YunRah2103/Remotion-gpt-chat/docs/modelling-kit/RECOVERY-2026-10-21.md

# Frozen-session recovery and visual audit

Recovered `30c1e799a62d43b73191cda30ba57cf82ebdecee` without replacing the branch or PR 233.
Implementation revision: `cf876818b2cf08c7ddab2bc3cc90a7d7310904a3`.

## Recovered media

Downloaded aggregate artifact **12380431702**, run **39669223178**.
ZIP SHA256: `207369eb3f63820cdb3c8d020929798d0ff10ee33dd51af45197af62c43ca4a2`.
All eleven MP4s passed the existing local verifier: native 1920x1080 or
1080x1920, H.264/yuv420p, 30fps, full decode and motion checks.
2,040 decoded frames were unique. Sequential 0.5-second samples from every
MP4 were visually inspected, including both driver/cabin and internal-system views.

The recovered dummy demonstrates seated grip, braking/impact posing and return
with visible seat/restraint hardware. Mechanical previews demonstrate the front
and rear layouts. This audit does not establish catalogue-wide collision clearance.
The body models remain stylised. Mechanical overview parts are small at portrait
scale; production agents should select dedicated close-ups when teaching a part.

## Corrections

- Portrait exterior overviews previously zoomed into crops late in each segment.
  They now retain the complete padded vehicle bounds throughout the orbit.
  Landscape detail shots and purposeful failed-wheel close-ups are retained.
- Camera-side lamps and rails crossed the Formula inspection view. Preview
  dressing now uses the far side of the road. The default scenery factory keeps
  both sides for other consumers and still uses six instanced draw groups.
- Collision/rewind reversed distance and damage but advanced the engine/particle
  clock. It now returns the reversed absolute frame, with paired 24/30/60fps tests.
  Negative seeks return the initial nonnegative animation state.

Four added regressions cover camera bounds, clear camera-side dressing,
rewind timing and negative seeks. Floating-point time comparisons use 1e-10
absolute tolerance to accommodate equivalent fractional timestamps.

## Automated verification

GitHub validation job **119483102384** passed TypeScript, **105 tests / zero
failures**, performance measurements and all eleven GLB export/roundtrip checks.
Composition review **39675194314** passed. The local complete suite also
finished with **105 passed / zero failures**.

## Native verification

New native workflow: https://github.com/YunRah2103/Remotion-gpt-chat/actions/runs/39675194371

Composition review: https://github.com/YunRah2103/Remotion-gpt-chat/actions/runs/39675194314

Both workflows passed at the implementation revision above. All eleven native
30fps video jobs and aggregate colour/decode/motion checks passed. Final aggregate
artifact: **12381493187** (all eleven MP4s, stills and verification reports).
ZIP SHA256: `5c06705c0c84eeab2e68c3a2a212e2e457f7034fe6a1933044ef068470d396d2`.

Downloaded the final pack and visually inspected sequential frames from every
updated MP4. Portrait A retains all three complete cars across each segment;
Formula C no longer has camera-side poles occluding the cutaway. Driver and
mechanical previews retain the recovered models and motions. Deliberate tyre
and Formula detail shots can still crop vehicle extremities. Some far-side lamp
heads pass behind the header; the kit demos are inspection footage, not final
captioned episode masters.

Local native rendering was attempted but Chromium download failed at the
network proxy; no render checks were bypassed. Native rendering/verification
instead completed through the established GitHub workflow.

| Preview | Landscape artifact | Portrait artifact |
| --- | --- | --- |
| A: exterior heroes | 12382578106 | 12381877122 |
| B: failed tyre | 12381907781 | 12382077676 |
| C: Formula floor | 12382621764 | 12382501728 |
| D: driver/cabin | 12383065841 | 12382187481 |
| E: shared internals | 12382437074 | 12382191356 |

Baseline artifact: 12381842418. All artifact IDs belong to native run 39675194371.
Download: https://github.com/YunRah2103/Remotion-gpt-chat/actions/runs/39675194371/artifacts/12381493187

This completes the recovery and targeted correction pass, not a premium
catalogue overhaul. Vehicle-specific powertrain plumbing, motorcycle riders,
full passenger rigs and individual model/collision approval across all variants
remain future work. Reuse the existing quick-start API and preserved models.

Vehicle, driver, restraint and mechanical geometry is unchanged in this pass.
EP003/EP004 sources are unchanged. No merge is authorized.
