YunRah2103/Remotion-gpt-chat/production/midnight_emerald/BOULEVARD_DB12_4K_EDITOR_HANDOFF_20261014.md

# YUNEX Midnight Emerald — Boulevard DB12 4K Supplement (14 October 2026)

**Verified native 4K MOVING FOOTAGE acquired.** Not the pre-existing South-of-France aerial material. This source was retrieved from the Boulevard editorial Vimeo embed.

- Publisher source: https://boulevard.co/post/videos/aston-martin-db12-video/
- Native Vimeo embed: https://player.vimeo.com/video/1006099458?h=efc07e05d4
- Authenticated GitHub original asset: https://github.com/YunRah2103/Remotion-gpt-chat/actions/runs/38601150775/artifacts/11913284188
- GitHub Actions conclusion: PASS; original MP4 + original 15-frame contact sheet + JSON probe manifest in artifact.
- **Native file:** `boulevard-db12-editorial.mp4`; 3840×2160 25fps H264; 63.680 sec; 166,267,232 bytes; SHA256 `1d4c8e1e93582cddf85012ab4ab8e524ebbe268225f58b0383ce40dc37421ccf`; full decode PASS.
- **Crucial appearance note:** actual DB12 is very dark *navy/blue-black*, NOT Iridescent Emerald. Some frames have a small BOULEVARD upper-right watermark. Copyright/publication rights are **NOT VERIFIED**. Treat as PRIVATE EDITORIAL REVIEW only until Boulevard and relevant music rights are cleared.
- User's existing original official green 1080p source was NOT re-downloaded and has not been changed.
- The user's Godfather song was not present in this footage specialist session; musical recommendations are phrase-relative (not actual beat timestamps).

## Verified editorial selections (original 4K source IN–OUT)

| Source IN–OUT | Visual | Music-relative suggested usage |
|---|---|---|
| 13.10–14.75 | elegant full side profile by woodland road | sculptural setup |
| 15.10–17.62 | rear-three-quarter beside scenic twisty road | road phrase continuation |
| 18.05–20.52 | very sunlit rear corner, reflection glint | lyrical lift |
| 20.94–22.86 | elevated moving rear-follow down winding road | landscape breathing moment |
| 41.78–43.46 | tight rear lamp and metallic panel reflections | refined detail punctuation |
| 43.55–45.38 | full front-three-quarter hero in architecture | orchestral entrance |
| 45.62–47.48 | moving fender vent, wheel and sculpted panel | musical flourish |
| 47.68–49.38 | driver cockpit, steering and cabin | intimate piano/strings |
| 49.56–51.40 | Bowers & Wilkins door speaker / quilted leather | romantic detail |
| 51.85–54.70 | premium frontal DB12 wide/near hero | melody climax |

**Preview media:** 10 independent 1920×1080 H.264 25fps muted MP4 excerpts prepared in specialist session; all individual FFprobe and full FFmpeg decode PASS; each SHA256 and exact timecode in companion `MANIFEST.json`. The original remains 4K for Master Editor to relink.

**Editorial recommendation:** Source is technically high grade with valuable *new* non-aerial shot categories (front, side, paint, wheel, luxurious interior), but NOT a drop-in emerald-colour match. The Master Editor must decide whether to incorporate blue/black detail shots, obtain licenced emerald footage, or make an intentional colour/story shift. Do not make false claims about same paint. Avoid title-heavy opening 0–12s and the repeated estate/drone 24–40s. Avoid assuming every shot is car driving: several are stationary subject/camera motion.

**Source rights:** Download does not itself grant publication licence. Contact publisher or filmmaker before posting. This is NOT an approved public distribution package.
