YunRah2103/Remotion-gpt-chat/production/mclaren_p1/episode003/V3_REMNANT_EDITOR_HANDOFF_20261016.md

# YUNEX EP003 — Remnant Media McLaren P1 V3 private cinematic footage selects

**Source-verified technical footage acquisition COMPLETE.** **Premium 4–7 fully approved footage rescue goal NOT completely achieved**: visually strong footage was acquired, but breathtaking unclipped 9:16 closer and genuine P1 on-track airbrake motion during braking remain unverified. No editor film has been edited.

## New source and asset proof

- Original filmmaker: **Remnant Media**; `https://www.youtube.com/watch?v=z_U29fm1nkk`. Source footage portrays one vivid **orange** road-going McLaren P1 in night garage and moving street shots; Sony FX3/MOVMAX as credited by filmmaker's source description. Does not match older **silver** car daylight footage.
- Authenticated S25 V4 source [issue #124](https://github.com/YunRah2103/Remotion-gpt-chat/issues/124) **PASS**. Owner-only **draft GitHub Release asset 647820346**, full original 0–120s, **1920×1080 H.264**, original SHA256 `a6e41655b28bdede9f778787286e8e851c33563a6f979355ac9cfdb395fc87eb`, full decode verified.
- Original still frame and center-crop QA [run 38927813240](https://github.com/YunRah2103/Remotion-gpt-chat/actions/runs/38927813240), 4fps timeline QA [run 38928304233](https://github.com/YunRah2103/Remotion-gpt-chat/actions/runs/38928304233).
- Seven-candidate verified private MP4 select builder [run 38937212932](https://github.com/YunRah2103/Remotion-gpt-chat/actions/runs/38937212932), output [artifact ID 12061712129](https://github.com/YunRah2103/Remotion-gpt-chat/actions/runs/38937212932/artifacts/12061712129). Contains **7 independent muted 1080p MP4s, 7 moving 9:16 cropped previews, 7 FFprobe records, wide and vertical 6fps contact sheets, correct SHA256 manifest**. Tool generated archive strips root `v2/`, so local handoff normalized verification paths before distribution.
- Curated final 5-shot owner-only ChatGPT package **`YUNEX_EP003_REMNANT124_V3_CURATED_5_PRIVATE.zip`**, 5,837,567 bytes, 28 entries including 10 actual MP4s. **Every one of 10 MP4s independently full-decoded PASS, SHA256 checked PASS, ZIP CRC PASS.** Detailed JSON and probes packaged; direct download link is available in the owner's ChatGPT conversation (it is not a public GitHub asset).

## Exact ORIGINAL video timecodes (0-based YouTube time)

| Curated MP4 basename | Source seconds | Editorial verdict | 1080p MP4 SHA256 |
|---|---:|---|---|
| `P1_OPEN_NIGHT_LOW_FRONT` | **61.73–63.60** | **GO** for fast-moving low frontal opening; trim before crop loses nose | `20623a48565687ecbd69ee011d066b0ba19da46851965acd8c0fad0d4afadc00` |
| `P1_MID_NIGHT_SIDE_RIG` | **58.75–60.95** | **GO** for same-car moving orange night side tracking | `a5658a1f1c8bdb992d9c7ee5a71090bfe8703243bc946a91ce9d46863b4af0d5` |
| `P1_MID_NIGHT_REAR_TRACK` | **55.30–57.15** | **CONDITIONAL** for blue-lit rear rolling, avoid left-edge crop | `0ca82fc004de4caefa1a17f168e60d4f8eb07366c46390f2a5da9c42d3b3b259` |
| `P1_END_NIGHT_REAR_ESCAPE` | **88.05–90.05** | **CONDITIONAL**, actual orange P1 rolling rear three-quarter with red-blue reflection; not an extraordinary guaranteed final shot | `33319e4c320b1052c798afe2119266b7df0d12aca64b624d4c57c569a47c50a2` |
| `P1_AERO_STATIONARY_WING_DETAIL` | **33.01–33.72** | **GO FOR STATIC MECHANICAL CONTEXT ONLY**: real raised rear wing on parked P1, camera physically moves, wing does NOT actuate | `0a4ebad801ae2cd819f5a941b6246b465e44591cfa52e88b445621714bee7a5b` |

**Private packet directory**: `ORIGINAL_1080P_SELECTS/` full landscape H.264, `VERTICAL_PREVIEWS_540x960/` real 9:16 center crops and `CONTACT_SHEETS/` images, `PRIVATE_EDITOR_MANIFEST.json`, `PROBES/`, `SHA256SUMS.txt`, `EDITOR_START_HERE.md`.

## Director execution notes

1. DO NOT randomly mix silver daytime P1 with orange neon/night P1; if using new pack, establish a visually intentional night chapter with cohesive car and grade.
2. Put `P1_OPEN_NIGHT_LOW_FRONT` as a possible first-frame hook. Real moving footage, P1 close and recognisable.
3. Cut `P1_MID_NIGHT_SIDE_RIG`, `P1_MID_NIGHT_REAR_TRACK` into a short coherent real-motion passage. Only use real duration; do not repeat, reverse or artificially duplicate to pad.
4. `P1_END_NIGHT_REAR_ESCAPE` is not an unconditional jaw-dropping end; review on device before approval, possibly keep previous edit ending if better.
5. `P1_AERO_STATIONARY_WING_DETAIL` can be paired with separate accurate animated engineering demonstration but **MUST NOT be captioned as wing deploying under braking**. No obtained film actually proved moving wing pitch on track.
6. **No source audio replacement**; preserve any user-approved soundtrack and previous documentary master. This job delivered footage only, not the edited documentary or video MP4.

## Honest output and rights limitations

- No native `1080x1920` output from source: vertical motion previews are 540×960 **UPSCALES** of a 608×1080 center crop of actual 1920×1080 landscape frames. Do not claim native portrait HD.
- Source filming is much more cinematic than tourist Nürburgring flybys, but low-light detail, fast edge clipping and two conditional excerpts remain. Quality is not guaranteed to meet user's very demanding "extraordinary full film" target.
- **Third-party media rights are UNVERIFIED**. Owner-only temporary reviews are not redistribution/publishing permission. Contact Remnant Media for commercial reuse permission or licensed master original prior to public posting.
- Status: **Technical sourcing/verification and 5-candidate private footage deliverable COMPLETE. Overall premium cinematic objective and publishing clearance NOT COMPLETE.**

Prior [V2 factual handoff](https://github.com/YunRah2103/Remotion-gpt-chat/blob/main/production/mclaren_p1/episode003/V2_RESCUE_FOOTAGE_HANDOFF_20261016.md) has silver/golden-footage options. This V3 is an **additional** single-car orange-night option; no approved prior assets deleted or changed.
