YunRah2103/Remotion-gpt-chat/production/yunex/chiron_quad_turbo/MASTER_EDITOR_AUDIO_HANDBACK.md

# YUNEX EP002 — Audio gate / Master Editor V2

## Recording dependency

GitHub issue #108 includes an approved narration SCRIPT. No approved Chiron-specific narration recording was found in the repository or in Library searches. GT-R/Porsche recordings belong to other episodes and are not substitutes.

“Why does the Bugatti Chiron need four turbos?
Its massive W16 engine doesn't use all four at once.
At low revs, just two turbochargers do the work, helping the engine respond quickly.
But around 3,800 RPM, the other two come alive, helping deliver incredible power as the engine climbs.
It's a clever two-stage system that helps make the Chiron so brutally fast.”

The script has no verified speech timestamps, and the 28.6-second edit timeline is a VISUAL ESTIMATE, not audio-locked. Do not invent word timings. Measure and verify the real voice MP3 before a final narration mix.

## Current private picture soundtrack

- Remotion film: 858 frames, 30fps, native 1080x1920.
- A newly synthesized, quiet original instrumental underscore is created by generate_private_score.py. It is a PROVISIONAL SCORE, not an approved music master.
- Actual S25 #107 Bugatti Chiron original source audio can be placed under performance shots if FFprobe identifies an audio track. It could include original music/voiceover, requiring a human listening pass to exclude vocal bleed. Engine sound is not independently listened or authorised for republishing.
- No narrator has been invented. The private picture master is NOT a fully narrated final.

## To finalize

1. Obtain a British voiceover MP3/WAV specifically approved for Episode 002, confirm SHA256, speaker, spoken text and real duration.
2. Align script to measured speech, retime footage around actual voice, preserve complete sentences.
3. Pass the owner-approved recording via PRIVATE workflow input, never commit a binary into the public Git repository.
4. Duck score and source Chiron engine beneath speech, listen at every splice, reject music/voice bleed and harsh clips.
5. Human-judge the three real vertical lookdev stills, 4s preview and final picture and reject any older-Veyron misleading engine material.
6. Verify the promotional-film reuse rights before uploading a final TikTok/Shorts/Reels cut.

Bugatti official engineering fact: the original 8.0L Chiron W16 uses two turbochargers at low revs, and the additional two join near 3,800rpm. Illustrated turbo positions are not claimed OEM mechanical geometry.
Source: https://newsroom.bugatti.com/press-releases/geneva-international-motor-show-2016
