YunRah2103/Remotion-gpt-chat/production/videos/abs-001/ASSETS.md

# ABS 001 reusable assembly

Preproduction briefing only. The models in `src/mechanics/parts.tsx` are simplified 3D building blocks, not a final ABS 3D film. A final lesson must include a physically sensible wheel/brake subsystem, wheel speed sensor, controller feedback and a hydraulic modulator with inlet/outlet valves; verify the pressure-release and reapplication cycle before publication.

This project remains separate from YUNEX. No published film is claimed by this directory.
