YunRah2103/Remotion-gpt-chat/production/yunex/chiron_quad_turbo/EDITOR_FOOTAGE_HANDOFF_20261015.md

# YUNEX EP002 — Bugatti Chiron Four Turbos | Verified Real-Footage Package
**2026-10-15 · One sole footage specialist · Source footage only · Issue [#104](https://github.com/YunRah2103/Remotion-gpt-chat/issues/104)**

## Final acquisition / technical delivery

**TEN technically verified, playable, silent H.264 1920×1080 MP4 source excerpts** from **THREE actual Samsung Galaxy S25 V4 acquisitions**, 32.485 seconds combined, 10,765,332 combined excerpt bytes. Each clip individually has successful actual FFprobe and full FFmpeg decode and a recorded SHA256. No graphics, narration, text overlays, music or edit were created.

**[OWNER-ONLY DRAFT RELEASE — YUNEX Chiron EP002 10 MP4s and contact sheets](https://github.com/YunRah2103/Remotion-gpt-chat/releases/tag/yunex-chiron-ep002-private-review)**

File: `YUNEX_CHIRON_EP002_PRIVATE_10_MP4S.zip`. Files: `CHIRON_*.mp4` (ten), `chiron-clip-manifest.json` (all SHA256/source timecodes), `manifest.json` (source FFprobe, scenes and sample times), `contact_105.jpg`, `contact_106.jpg`, `contact_107.jpg` (real frame contact sheets with center 9:16 proof), and `CHIRON-README.txt`.

**[GitHub Actions real processing run #38806038293](https://github.com/YunRah2103/Remotion-gpt-chat/actions/runs/38806038293)** — completed SUCCESS, importer PASS 3/3, scene/contacts PASS, 10/10 clip extracts individually PASS, private Release upload PASS.

Rights unverified means this is an **authenticated private GitHub download**, not a public MP4 download. No assets from this third-party footage package are to be published to a public Release, Git history, or social media without creator permission.

## Actual MP4s / exact real source in-out points

The entries below are precise FFmpeg source cut boundaries in the S25-recorded original windows that all start at source 00:00. They were **machine scene-selected**, not human-directed best-shot rankings. Every clip is 1920×1080 H.264, full-decode PASS, muted. Original phone source #105/#107 25fps, source #106 24fps.

| Actual MP4 inside private ZIP | Source job | Original in–out (seconds) | Measured extracted duration | FPS | SHA256 |
| --- | --- | --- | ---: | --- | --- |
| `CHIRON_105_01.mp4` | [#105](https://github.com/YunRah2103/Remotion-gpt-chat/issues/105) | 5.650–9.350 | 3.720s | 25/1 | `f00e753656e26b36502f0738f8c0d84867e74f8888865e1ae41f4ad550686185` |
| `CHIRON_105_02.mp4` | [#105](https://github.com/YunRah2103/Remotion-gpt-chat/issues/105) | 17.980–21.680 | 3.720s | 25/1 | `51ed365db428c64ae0c8b21c8510a118c037144c3a332f14c34b73bc04d324f8` |
| `CHIRON_105_03.mp4` | [#105](https://github.com/YunRah2103/Remotion-gpt-chat/issues/105) | 36.920–39.240 | 2.320s | 25/1 | `a0632fb267bdf79bc8c42776daae421b295b9f419948e33928bc89f5483ed7bf` |
| `CHIRON_105_04.mp4` | [#105](https://github.com/YunRah2103/Remotion-gpt-chat/issues/105) | 52.880–55.400 | 2.520s | 25/1 | `03c210b22164cecb53a439d9bdbc7764d66fd1692c4adbb65c9e8d9529854b0c` |
| `CHIRON_106_01.mp4` | [#106](https://github.com/YunRah2103/Remotion-gpt-chat/issues/106) | 13.150–16.850 | 3.708s | 24/1 | `8ac0272cf5bf25bc85a021c5f233c0737cd7f5fa64c0f346eb0cba115917d542` |
| `CHIRON_106_02.mp4` | [#106](https://github.com/YunRah2103/Remotion-gpt-chat/issues/106) | 39.758–43.458 | 3.708s | 24/1 | `f42db5fb618bbb398f41c789c581d7e2985aa1451a49cfdf72964703858a8f2b` |
| `CHIRON_106_03.mp4` | [#106](https://github.com/YunRah2103/Remotion-gpt-chat/issues/106) | 73.458–77.158 | 3.708s | 24/1 | `d0a30041df898e267c43b46a20b75b9f32ee9d64b3b17037d4affd7a49932e47` |
| `CHIRON_107_01.mp4` | [#107](https://github.com/YunRah2103/Remotion-gpt-chat/issues/107) | 7.880–10.920 | 3.040s | 25/1 | `1b49ae58cd9e354d680f203d344720033ae9131f65968f345883793888b14cfd` |
| `CHIRON_107_02.mp4` | [#107](https://github.com/YunRah2103/Remotion-gpt-chat/issues/107) | 20.420–24.120 | 3.720s | 25/1 | `58d1fda7fd92b8abcaada0fd431c5121ce8b051dce6d0ca632cda0111eec81c0` |
| `CHIRON_107_03.mp4` | [#107](https://github.com/YunRah2103/Remotion-gpt-chat/issues/107) | 38.960–41.280 | 2.320s | 25/1 | `b81f03d86324aaf1d7e2ac6035357e92c488c7ac5af59b33f328e304bf2ad654` |

## Proven originals

- **#105** `https://www.youtube.com/watch?v=vIy2KFeGLtg` — 60s promotional blue Chiron source candidate via YOUCAR (original manufacturer rights). S25 full decode PASS, 1920×1080 25fps H.264, 21,949,605 bytes. SHA256 `b50874f763133846599cdbf00ecc5ede709f4f01c089db7799b05c38ea9268a3`. [Private original draft](https://github.com/YunRah2103/Remotion-gpt-chat/releases/tag/untagged-d8339a626a4f14cce6e9). **Candidate purpose:** distinctive opening car reveal, headlights, grille and closing alternate. Verify original blue colour / motion and avoid static intro.
- **#106** `https://www.youtube.com/watch?v=gwrQ3cXttio` — 90s manufacturer W16 historic film, S25 full decode PASS, 1920×1080 24fps H.264, 31,081,879 bytes. SHA256 `93b333fa1e737b1d82c34551de5bddbca76ba9691d59f479340da8e25d3a3c5b`. [Private original draft](https://github.com/YunRah2103/Remotion-gpt-chat/releases/tag/untagged-26676228cfa0331a134c). **Critical:** this historical film features Veyron and other W16 eras; reject any misleading Veyron engine/turbo as being original Chiron hardware. Do not infer technical correctness from filename.
- **#107** `https://www.youtube.com/watch?v=PkkV1vLHUvQ` — 45s official 0–400–0 film shot with second Chiron camera car, S25 full decode PASS, 1920×1080 25fps H.264, 17,380,734 bytes. SHA256 `d7a83781d83d8de40fc318030d21fb65b9244ed93c40189bafaef6f8a14116ec`. [Private original draft](https://github.com/YunRah2103/Remotion-gpt-chat/releases/tag/untagged-c766ffb1bc7f43285300). **Candidate purpose:** authentic velocity payoff, low tracking, performance closing. Note 0–400–0 visuals do not show exact turbo stage activation.

## Editorial briefing and objective gates

1. **Opening / 0–5s:** choose the strongest ACTUALLY WATCHED front-three-quarter moving blue Chiron shot from #105, #107 as fallback. Car readable in first fraction of a second; preserve room for an unobtrusive title.
2. **W16 / 5–11s:** genuine original Chiron W16 turbo/engine hardware if confirmed in #106 after viewing private frames; use technical diagram for 2-turbo initial stage, *not* a Veyron-hardware shot falsely labelled Chiron.
3. **Transition / 11–20s:** show motion/details from the real source shots and editor's accurately labelled animated sequential diagram. Bugatti factory statement: original Chiron 8.0L quad-turbo W16 uses pair at low RPM; second pair engages near 3800 RPM. See https://newsroom.bugatti.com/press-releases/geneva-international-motor-show-2016 and https://newsroom.bugatti.com/press-releases/bugatti-w16-engine-the-last-of-its-kind.
4. **Performance / 20–28s:** #107 real acceleration, smooth blue/neutral colour match, no footage-repetition, compelling final hero or loop from verified actual moving frames.
5. **Visuals not personally approved:** Repo connectors/Actions have confirmed *decoded actual media bytes and generated real frame contact sheets*, but the sole current footage specialist did **not** directly open/visually inspect the PRIVATE frames via an image viewer. Consequently **do NOT claim** all ten contain exceptional shots, no black bars, tight readable center 9:16 framing, a particular car colour or the right engine hardware. The Editor/owner MUST view the private contact images and actual videos and reject unsuitable cuts. Also, cropping 1920×1080 to 9:16 yields only approx 608×1080 original source pixels without upscaling; track the subject, do not claim native portrait 1080 resolution.
6. **Rights gate:** All three are unverified manufacturer/filmmaker copyrighted sources stored owner-only. Private technical download != creator permission for public TikTok/Instagram/Shorts. Seek approval/replacement legally cleared source for public film.

## Additional real filmmaker options (not downloaded, not licensed)

- Gijs Hartog / Amain Films' [Chiron's Soar](https://vimeo.com/1020311160) — stunning multi-Chiron rain driving, [The Filmcar](https://www.thefilmcar.com/project/bugatti---chirons-soar) production; permission required.
- Marcel Dambon [Making The Chiron](https://vimeo.com/226895580) — factory documentary; actual engineering identity review / permission required.
- Simon Puschmann [Bugatti Chiron Pur Sport](https://www.simonpuschmann.com/work/bugatti-chiron-pur-sport/) — authentic but **Pur Sport is variant-mismatched** to original 2016 Chiron; use only with explicit disclosure/permission.
- OUTRUN / director Al Clark's 0–400–0 film BTS [Duncan Catterall project](https://www.dcfilm.com/bugatti) — already covered by phone #107; do not redownload.

**Task scope:** acquisition/tech QA/handoff only. Do not launch new agents, edit Remotion, or add narration/audio. The Master Cinematic Editor chooses final visual selects and creates the actual explainer. This package is complete at the **technical** level, not final cinematographic or publication-clearance level.
