YunRah2103/Remotion-gpt-chat/production/mclaren_p1/episode003/EP003_V5_EDITOR_REPORT.md

# YUNEX Episode 003 — V5 Orange Night McLaren P1 — PRIVATE REVIEW DELIVERED

**Date:** 16 October 2026. **Editor:** GPT-6. **Production:** GitHub issue #125, replacement footage #118/#124.

## Actual finished private MP4 (delivered in the owner's ChatGPT conversation)

- Filename: `YUNEX_EP003_V5_McLaren_P1_ORANGE_NIGHT_PRIVATE_REVIEW.mp4`
- SHA256: `7fc67e56406e6e058a62085b0b6f484ca967a15269ffd4fb45790f26491b9322`
- Actual file size: **26,629,474 bytes**.
- FFprobe: **19.100 s; 573 frames; 1080×1920 30fps H.264; 48kHz stereo AAC**.
- `ffmpeg -xerror -i V5.mp4 -f null -`: full audio/video decode **PASS**.
- AAC streamhash **identical** to latest owner V4 jazz/Cedar/engine master (`YUNEX_EP003_V4_FINAL_CHILL_JAZZ_P1_ENGINES.mp4`): `d6cf5c14568074df930c36635f332292bce120889a118cc94cdd3b6bcf11626c`. No approved audio content was replaced or rearranged.
- 6-second moving look proof and three full-height portrait inspection stills generated and reviewed before full render. Final dense first-second/last-three-second contact sheets inspected; car is visible and moving at beginning and throughout ending. No empty raceway finish.

**Private deliverables:** Owner's ChatGPT session has the MP4, a 6-second excerpt, and `YUNEX_EP003_V5_PRIVATE_SOURCE_AND_QA.zip` (scripts, EDL/QA manifest, frame contacts; excludes source footage/music). ChatGPT sandbox URLs are *not* permanent GitHub artifact links. Files not published to GitHub.

## Actual editorial construction

| Edit time | Picture |
|---|---|
| 0.00–1.73 | Remnant #124 orange P1 blue-lit low frontal approach; car moving from first frame |
| 1.73–3.93 | Same orange P1 cinematic side rig |
| 3.93–4.70 | Genuine *stationary, already raised* orange rear wing closeup, explicitly marked parked |
| 4.70–5.47 | Orange rear moving pursuit |
| 5.47–8.47 | Newly restyled 3D **illustrative** wing pitching, explicitly demonstrating increased drag and rear downforce |
| 8.47–10.73 | Nonoverlapping continuation of rear moving pursuit |
| 10.73–13.47 | 3/4 rolling orange front road view |
| 13.47–16.90 | Blue-lit moving rear tracking |
| 16.90–19.10 | Red-blue moving orange P1 rear/side exit, car continually visible |

No existing silver track aerials, industrial warehouse opening, empty track ending or other YUNEX footage was included. Visual framing and true-source motion inspected. No audio or source bytes publicly committed.

**Engineering truth:** The real orange wing clip is *parked and already raised*, not pitching under track braking. The 3D section is labelled `ILLUSTRATIVE MECHANISM / NOT LIVE BRAKING`, not manufacturer CAD or simulated CFD. More drag and more rear downforce from increased wing angle at high speed are conveyed as separate effects, no claim that slowing speed increases downforce.

## Editorial limitations, not concealed

- Remnant source is native **1920×1080 landscape**, not native full-resolution vertical. True portrait photo detail is limited by landscape extraction and scaling.
- Side macro is inherently tight; 3/4 middle shot is farther away and the red-blue ending does not establish a licensed breathtaking portrait-specific commercial master. The V5 shows a coherent moving nighttime P1 with a much stronger opening than rejected V4, but final *creative approval/10-out-of-10 rating remains the owner's*.
- **Reuse rights for Remnant Media footage are still UNVERIFIED.** The delivered MP4 remains owner-only private review and **must not be publicly posted** before explicit creator permission/licensing.
- The historical V4 production was not a Remotion composition: its actual editor kit was OpenCV/VTK/FFmpeg. V5 continues that verified media-conform pipeline; scripts are in the owner's private V5 kit. Do not misstate that Remotion rendered this MP4.

**Status:** Final 19.1-second private-review film rendered and technically QA **PASS**. Publishing clearance and subjective creative acceptance **PENDING**.
