YunRah2103/Remotion-gpt-chat/production/mclaren_p1/episode003/EP003_V3_EDITOR_REPORT.md

# YUNEX Episode 003 — Master Cinematic Edit V3 (owner-only review)

**16 October 2026** — New visual treatment rebuilt from verified footage. Not an update to the rejected 19.2s original visual design.

## Render delivered
- `YUNEX_EP003_V3_P1_AIRBRAKE_MASTER.mp4` — private ChatGPT attachment, 1080x1920, H.264 + AAC, 30fps, 19.100s.
- `YUNEX_EP003_V3_P1_AIRBRAKE_UPLOAD.mp4` — upload-friendly private ChatGPT attachment, same resolution/framerate/duration.
- `YUNEX_EP003_V3_FINAL_CONTACT_SHEET.jpg` — frame samples across completed render.
- `YUNEX_EP003_V3_LOOKDEV/LOOK_0016.jpg`, `LOOK_0348.jpg`, `LOOK_0790.jpg` — actual 1080x1920 rendered look-dev frames; `OPENING_AND_AERO_TEST.mp4` — source-derived partial motion test.
- Every MP4 was checked with FFprobe and a complete FFmpeg -xerror video/audio decode. None of the third-party footage or rendered film was published to a GitHub release; deliverables live in current private ChatGPT session, not persistent repository assets.

## Material/creative changes
- Removed the permanent 'ENGINEERING FILE 003' header, oversized green typography and generic static arrows; small context labels only.
- Rear trackside Nürburgring P1 flyby in opening frame, then **actual stationary Race Mode silver P1 wing-rise** and further silver Nürburgring P1 driving.
- Experimental 4.24s procedural animated airfoil schematic illustrates a changing pitch, wake/drag and increased rear tyre load; explicitly marked *simulated*, never filmed track braking.
- One existing user-approved **Cedar** voiceover, original bytes preserved, mixed with a newly built subtle score. Narration not regenerated. Minimal contextual typography.
- Vertical dynamic reframing; true 1080x1920 output, but original source was 1920x1080 / some baked cinematic matte. Crops necessarily use upscaled photographic source pixels and do NOT imply native 4K photography.

## Crucial factual caveats
- Authentic *wing rises from stationary Race Mode* in Shmee150 original 156–165s; verified.
- **No real film proves wing pitching under active braking on track.** The engineering overlay is a schematic, not real braking footage.
- Actual P1 driving shots do not independently demonstrate braking pedal activation; describing rear downforce/drag is based on McLaren technical documentation.
- Actual source publication/redistribution permissions are **not yet established**. Private internal review only.
- This is a *provisional editorial cut*, not proof of artistic approval or retention improvement. Viewer/director review still determines acceptance.
