YunRah2103/Remotion-gpt-chat/production/mclaren_p1/LFA_REFERENCE_SHOT_GUIDE_20261014.md

# YUNEX McLaren P1 — Lexus LFA visual reference analysis

Reference supplied: `192911.mp4`, duration 16.207s, 1920x1080, HEVC 60fps, AAC. Inspected frame contact sheet at 2-second spacing on 14 Oct 2026. This is an editing-style reference, **not footage to incorporate**.

## Observed visual grammar
- 0–2s: rear quarter / spinning wheel macro, hard mechanical opening.
- ~2–4s: instrument cluster, cut to moving front three-quarter track car.
- ~4–8s: low front tracking and banking/cornering progression.
- ~8–12s: close-up of tachometer / instrument, followed by long circuit perspective.
- White high-contrast editorial titles at top-left, smaller data/specification typography, secondary title at lower-right; avoid copying original wording/brand graphics.
- Compact, high-energy editorial rhythm; prioritize true car motion and precise soundtrack sync.

## Existing McLaren P1 mapping (prior visual QA)
- Mechanical open: #70 wheel 12.1–14s, or #63 rear-cover sweep 2–6.8s; both orange stationary car. Check source crop and overlays before use.
- Cockpit: #62 1.5–4.5s or #70 1.2–5.5s; no falsely implied tachometer movement.
- Hero: #69 side 1.3–2.8s; headlight 3.1–6.8s; doors-up front 9–11.7s; #68 orange parked exterior 7–10.4s.
- Actual performance: #74 SILVER road P1, downloaded clip 33–37s close corner exit, 44–48s rear three-quarter pass, 49–60s aerial switchbacks. Source 45–105s from official McLaren Nürburgring video; source-relative times 78–82, 89–93, 94–105s. 1920x1080 H.264, 60s, phone and prior direct editorial QA PASS; artifact https://github.com/YunRah2103/Remotion-gpt-chat/actions/runs/38465916924/artifacts/11849070032 . Baked letterbox.
- #66 first 30s scenic footage with no visible P1 in sampled frames; #71 static/watermarked. Do not represent either as acceleration.

## Editorial guardrails
Treat orange static beauty footage and silver track footage as distinct shoots. Never imply one continuous same-car action. The supplied original music remains locked; audio specialist owns beat mapping. Director owns final cut and typography. Rights/publication permission unverified. No new footage acquisition necessary until first assembly exposes a specific missing shot.
