YunRah2103/Remotion-gpt-chat/(commit log)

2026-10-08 Direct 840-frame turbo documentary with cinematic 3D cameras and captions
2026-10-08 Fix opening camera interpolation keyframes
2026-10-08 Add native WebGL previews and parallel full-resolution 840-frame master render pipeline
2026-10-08 Publish validated 840-frame Turbo Documentary MP4 from finished native render chunks
2026-10-08 Install and verify headless creative toolkit
    * Add isolated headless creative toolkit and actual cross-tool smoke tests
    * Fix empty Blender world initialization found by real CI render
    * Disable unavailable Ubuntu Cycles denoiser; exercise all mechanical tools before render
    * Fix NumPy dependency and independently test all four 3D toolchains
    [wheel_ring.scad]
2026-10-09 Install reusable automotive video production suite
    * Add reusable production scripts, catalogue, frame QA and video scaffolding
    * Add real reusable 3D mechanism components, safe GLB optimization and production unit tests
    * Add parameterised GitHub render, CI, Release, Pages, and guarded GLB Actions workflows
    * Add visual regression, timing and audio tools, plus dependency bootstrapping
    * Lock exact npm dependency versions for cached reproducible CI
    * Fix genuine CI failures, preserve GLB anchor ancestry and align reusable wheel geometry
    * Document full production toolkit and scaffold reusable ABS 001 lesson assets
    * Exercise visual regression with generated before/after images in cach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
2026-10-09 Install five integrated production upgrades for automotive engineering videos
    * Add real registered captioned Remotion compositions and production brief preflight
    * Resolve @remotion/captions lockfile reproducibly using GitHub Actions
    * Pin Remotion captions exact dependency tree
    * Add changed-source aware composition selection for native visual QA
    * Add bounded native render speed and peak memory measurement
    * Add strict agent handoff manifest integrity checks
    * Automate composition-specific native still and moving frame proof
    * Replace fixed GPU PR QA with dynamic composition-aware native image and motion evidence
    * Add end-to-end preflight, proof and five-way native final render p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
2026-10-09 Add verified 3D model lab, sound mixing, phone QC, studio lighting and production dashboard
    * Install interactive Three.js GLB mechanical viewer with mesh isolation and exploded views
    * Install interactive Three.js GLB mechanical viewer with mesh isolation and exploded views
    * Build production status dashboard from factual project briefs and GitHub snapshots
    * Add deterministic mechanical sound cue synthesis and narration-safe FFmpeg mastering
    * Install phone safe-zone masks, declared text/subject collision checks and screenshot proof
    * Add opt-in engineering material and studio lighting presets with native proof scene
    * Add opt-in engineering material and studio lighting presets with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
2026-10-10 build(footage): pin yt-dlp and its supported EJS extras
2026-10-10 build: pin Pillow and PySceneDetect headless for native video review
2026-10-13 docs(agents): current V4 proofs, audio-only option, efficient polling and private draft permissions
2026-10-13 Recover and visually sample existing P1 phone assets 69 70 71
2026-10-14 docs(p1): frame-reviewed LFA reference and verified footage mapping
2026-10-14 Probe public live-action Aston DB12 filmmaker and manufacturer sources without credentials
2026-10-14 Trace public Aston DB12 press video download endpoint and permissions
2026-10-14 Complete Dailymotion full format metadata probe after missing-key crash
2026-10-14 YUNEX temporary encrypted 4K source handoff for user-requested editor cut
2026-10-15 feat(yunex): real editor-grade shot, speed, sound and typography toolkit
    Add FFmpeg source cut scout and contact sheets, non-destructive source-based speed ramp exporter, loudness/true-peak diagnostics, original frame-based kinetic titles, tested Actions workflow and YUNEX editor playbook.
2026-10-15 feat(yunex): add private GT-R source frame and scene inspection utility
2026-10-15 ci(yunex): privately inspect 3 recovered GT-R R35 media and save frame previews to draft release
2026-10-15 feat(yunex): eight premium cinematic automotive colour LUT filters
    Add eight original SDR film-grade 33-point .cube presets with adjustable-strength FFmpeg renderer, original AAC preservation, real A/B contact-sheet previews, full video/audio CI QA, source safety checks and editor documentation.
2026-10-15 fix: show distinct forward ATTESA torque prop shaft
2026-10-15 feat(yunex): cinematic landscape R35 ATTESA explainer with drivetrain animation and verified-source slots
2026-10-15 feat: director's cut GT-R detail, 9 camera setups, richer voxel automotive cinematography
2026-10-15 Match closing Chiron take duration to real 2.32s source without frozen frames
2026-10-15 Set Chiron film duration to 858 frames / 28.6s of actual source footage
2026-10-15 Gate Chiron lookdev on real rendered 1080x1920 frames without black slabs
2026-10-15 Compose original restrained synthetic instrumental guide bed; never replace missing Chiron narration
2026-10-15 Fix Chiron V2 frame-count QA parsing for ffprobe CSV trailing comma
2026-10-16 EP003: private verification of already-downloaded genuine P1 wing footage
2026-10-16 Fix P1 wing private QA: install ffmpeg before verification
2026-10-16 EP003: recover and visually verify existing phone #112 rear-wing footage
2026-10-16 YUNEX EP003: verified P1 active wing footage handoff with exact sources and permissions
2026-10-16 EP003: inspect genuine P1 wing motion in completed S25 #116 video
2026-10-16 docs: update EP003 eight verified selections and actual moving-wing limitations
2026-10-16 Probe public producer-hosted P1 film after Vimeo requires login
2026-10-16 Frame-verify P1 vs MSO HS identity and honest mobile crops on new #120 source
2026-10-16 Precisely review P1 #123 peak flybys, frame-by-frame and true mobile crop
2026-10-16 Sample Remnant P1 20-110s at 4fps for accurate vertical shot selection
2026-10-16 docs: record V6.1 narration/wing opening sync fix with identical AAC and verified V6 tail
2026-10-19 AI ERA: expanded real-source lineup with Edit Lab V3 (#188)
    * feat(ai-era): beat-synced 13-source cinematic real footage cut with sourced Atlas and Sora
    * feat(ai-era): add expanded real footage composition without altering original edit
    * ci(ai-era): integrate V3 real shot scout and audio meter into 13-source Samsung V4 Remotion film
    * edit(ai-era): align model reveal cut points with measured original-song transient accents
2026-10-19 AI ERA V3: safer music mix and real-master true peak gate (#190)
    * mix(ai-era): preserve submitted song timing but add -2.27 dB mix headroom after V3 true-peak audit
    * mix(ai-era): preserve submitted song timing but add -2.27 dB mix headroom after V3 true-peak audit
    * ci(ai-era): run V3 final true-peak gate and include audio QC JSON with private master
    * fix(ai-era): retain correct SHA256 probe and upload V3 loudness report with private film
2026-10-19 AI ERA: original footage V3 cinematic remix and private render workflow (#191)
    * feat(ai-era): cinematic V3 seven-AI cut on verified 35.6s audio transients with real footage only
    * feat(ai-era): register alternate beat-precise genuine footage V3 composition
    * ci(ai-era): V3 real-source scout and cinema cut render with private release plus mastering checks
